majsterklepka/varbose-potato/README.md

# varbose-potato
Digital Voltmeter based on ICL7107

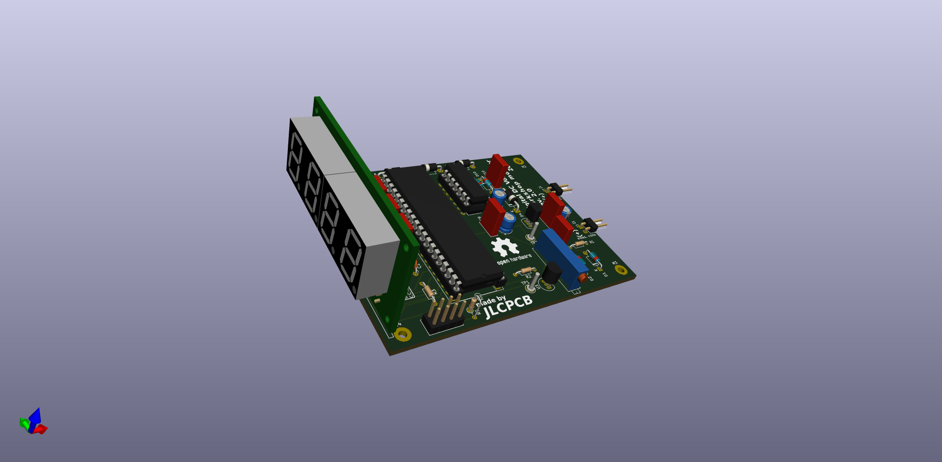
[picture p1: voltmeter/ICL7107.png]
Digital Voltmeter
