majsterklepka/varbose-potato/voltmeter/BOM.ods

Digital DC Voltmeter BOM
Item | Qty | Reference(s) | Value | URL | Comments
1 | 1 | C1 | 100p | https://sklep.avt.pl/45298.html
2 | 2 | C2, C3 | 0.47u | https://sklep.avt.pl/45319.html
3 |  | C4 | 0.22u | https://sklep.avt.pl/41558.html
4 | 1 | C5 | 0.1u | https://sklep.avt.pl/41542.html
5 | 2 | C6, C8 | 100u | https://sklep.avt.pl/kondensator-elektrolityczny-100uf-16v.html
6 | 2 | C7, C9 | 100n | https://sklep.avt.pl/41542.html
7 | 1 | C10 | 0.47u | https://sklep.avt.pl/45319.html
8 | 1 | C11 | 10u | https://sklep.avt.pl/kondensator-elektrolityczny-10uf-50v-10-szt.html
9 | 2 | D1, D2 | 1N4148 | https://sklep.avt.pl/42281.html
10 | 1 | D3 | LED-Display_x4_CA |  | module with two double display 0.56’’ CA
11 | 5 | D4, D5, D6, D7, D8 | 1N4001 | https://sklep.avt.pl/42280.html
12 | 2 | D9, D10 | 1N914 | https://allegro.pl/oferta/dioda-1n914-300ma-100v-do35-tht-x20szt-7876530202 | 1N4148
13 | 1 | G1 | CC-BY-SA
14 | 1 | J1 | +9...12V DC | https://sklep.avt.pl/zlacze-srubowe-dg301-5-0-2-raster-5mm-wys-10mm-niebieski-ark2-500.html
15 | 1 | J2 | DP conn. | https://sklep.avt.pl/listwa-kolkowa-2x40-prosta-gold-pin.html
16 | 1 | J3 | meas. conn | https://sklep.avt.pl/zlacze-srubowe-dg301-5-0-2-raster-5mm-wys-10mm-niebieski-ark2-500.html
17 | 1 | LOGO1 | Logo_Open_Hardware_Large
18 | 4 | M1, M2, M3, M4 | M2.2
19 | 1 | R1 | 1M | https://sklep.avt.pl/rezystor-1mom-1-4w-5-0207-10-szt.html
20 | 1 | R2 | 6k8 | https://sklep.avt.pl/rezystor-6-8kom-1-4w-5-0207-10-szt.html
21 | 1 | R3 | 100k | https://sklep.avt.pl/rezystor-100kom-1-4w-5-0207-10-szt.html
22 | 1 | R4 | 47k | https://sklep.avt.pl/rezystor-47kom-1-4w-5-0207-10-szt.html
23 | 1 | R5 | 470R | https://sklep.avt.pl/rezystor-470om-1-4w-5-0207-10-szt.html
24 | 1 | RV1 | 20k | https://sklep.avt.pl/potencjometr-pr20kom-helitrim-3006p.html
25 | 1 | U1 | LM285Z-1.2 | https://allegro.pl/oferta/lm285z-zrodlo-napiecia-odniesienia-1-2v-icl8069-7283614293
26 | 1 | U2 | ICL7107 | https://sklep.avt.pl/uklad-scalony-icl7107.html | socket: https://sklep.avt.pl/podstawka-40-pin.html
27 | 1 | U3 | L7805
28 | 1 | U4 | CD4069 | https://sklep.avt.pl/uklad-scalony-4069.html | socket: https://sklep.avt.pl/podstawka-14-pin.html
29 | 2 | TP1,TP2 | goldpin | https://sklep.avt.pl/kolek-lutowniczy-10szt.html
