majsterklepka/varbose-potato/display-module/BOM.ods

Display-module
Reference | Quantity | Value | URL | Comments
D1 D2 | 2 | HDSP-5623-CA | https://sklep.avt.pl/wyswietlacz-czerwony-2-cyfry-14-2mm-wa.html | various CA LED Display 0.56’’
J1 J2 | 2 | Conn_DP1 | https://sklep.avt.pl/listwa-kolkowa-2x40-katowa-gold-pin.html
M1 M2 M4 M3 | 4 | Conn_01x01
