majsterklepka/varbose-potato/ICL7107.pdf

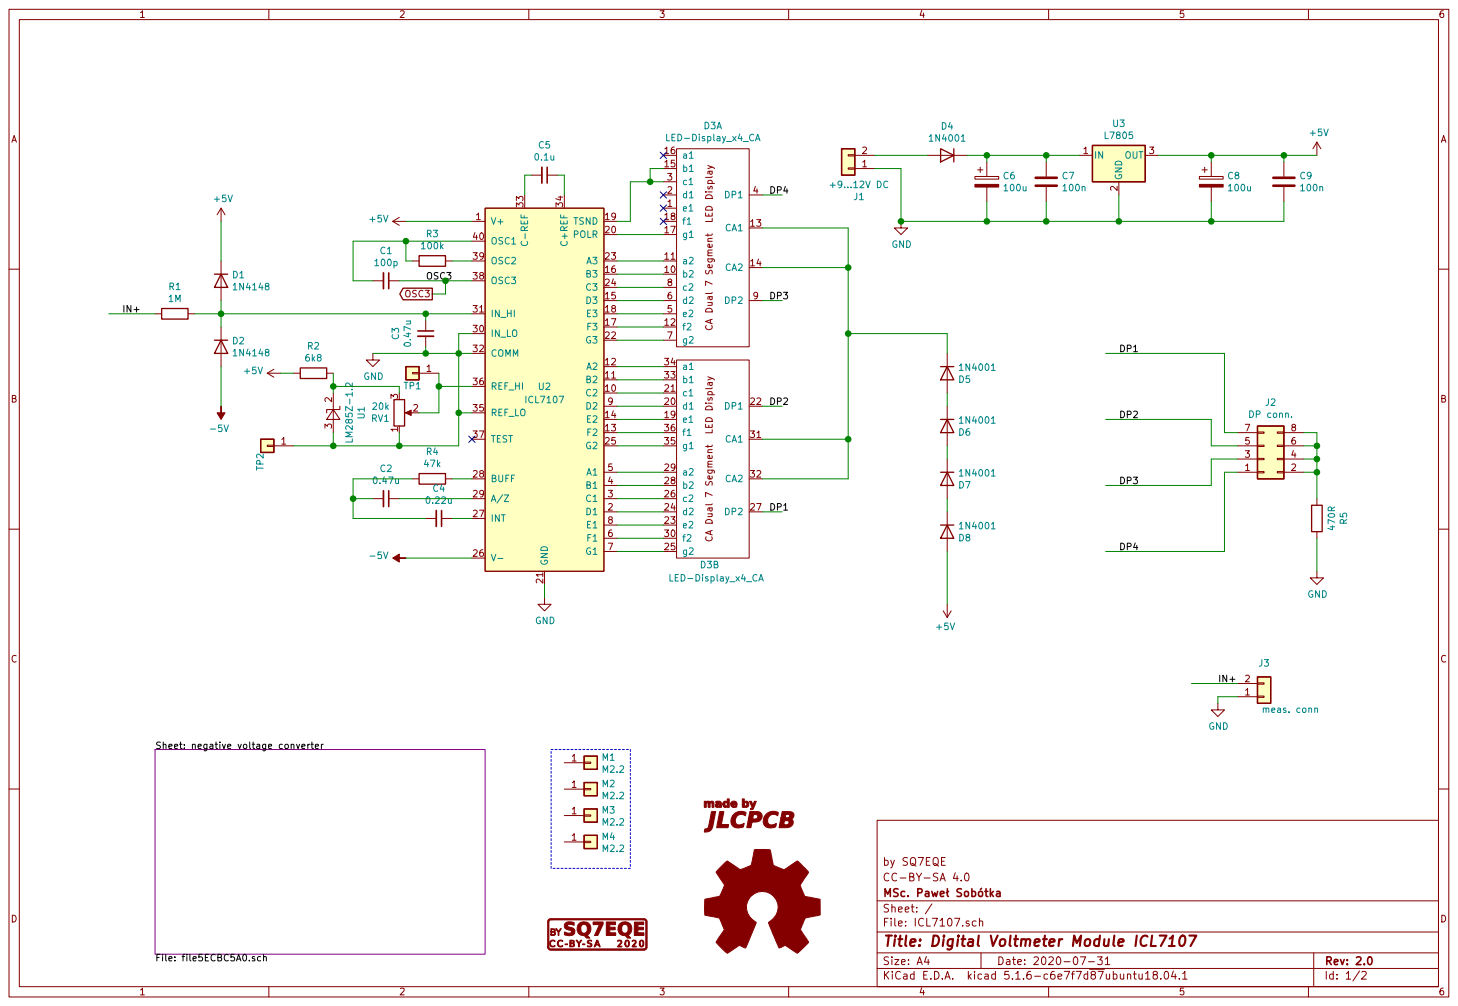
[picture p2: page 1]

LED-Display_x4_CA CA Dual 7 Segment LED Display e1 1

Sheet: negative voltage converter File: file5ECBC5A0.sch

by SQ7EQE
File: ICL7107.sch Sheet: / MSc. Pawe Sobótka CC-BY-SA 4.0

Id: 1/2 Title: Digital Voltmeter Module ICL7107

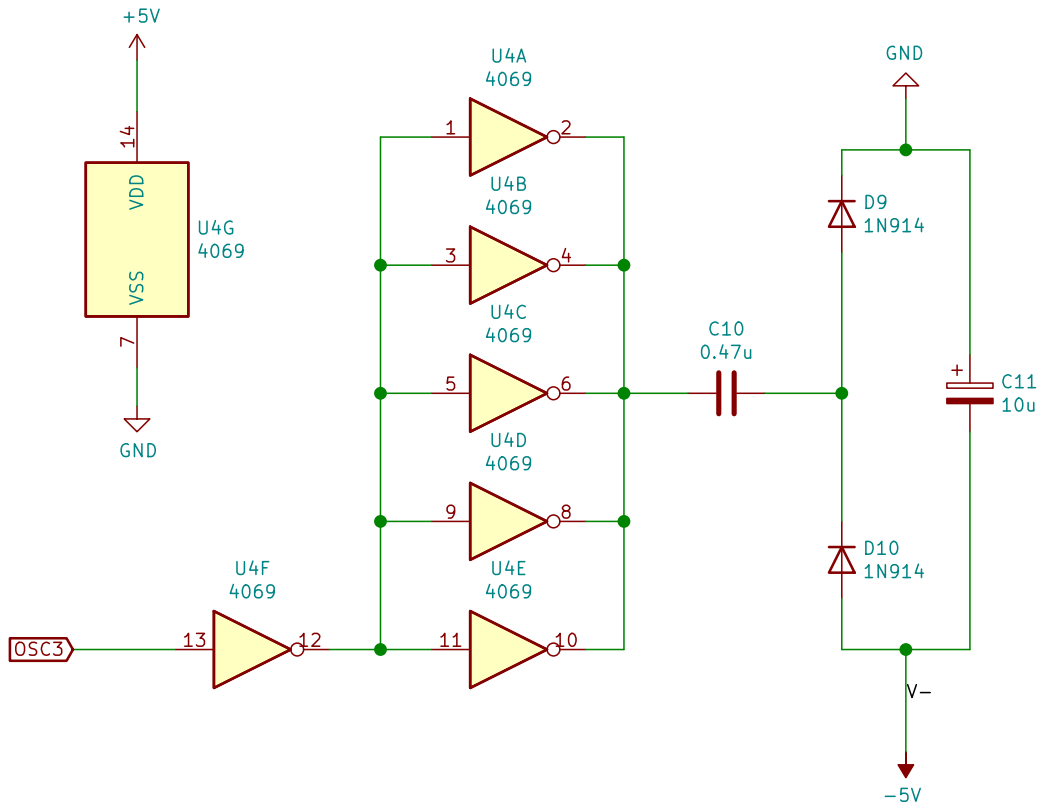
[picture p3: page 2]

by SQ7EQE
MSc. Pawe Sobótka CC-BY-SA 4.0

Id: 2/2 Title: negative voltage converter File: file5ECBC5A0.sch Sheet: /negative voltage converter/
