majsterklepka/varbose-potato/voltmeterac.pdf

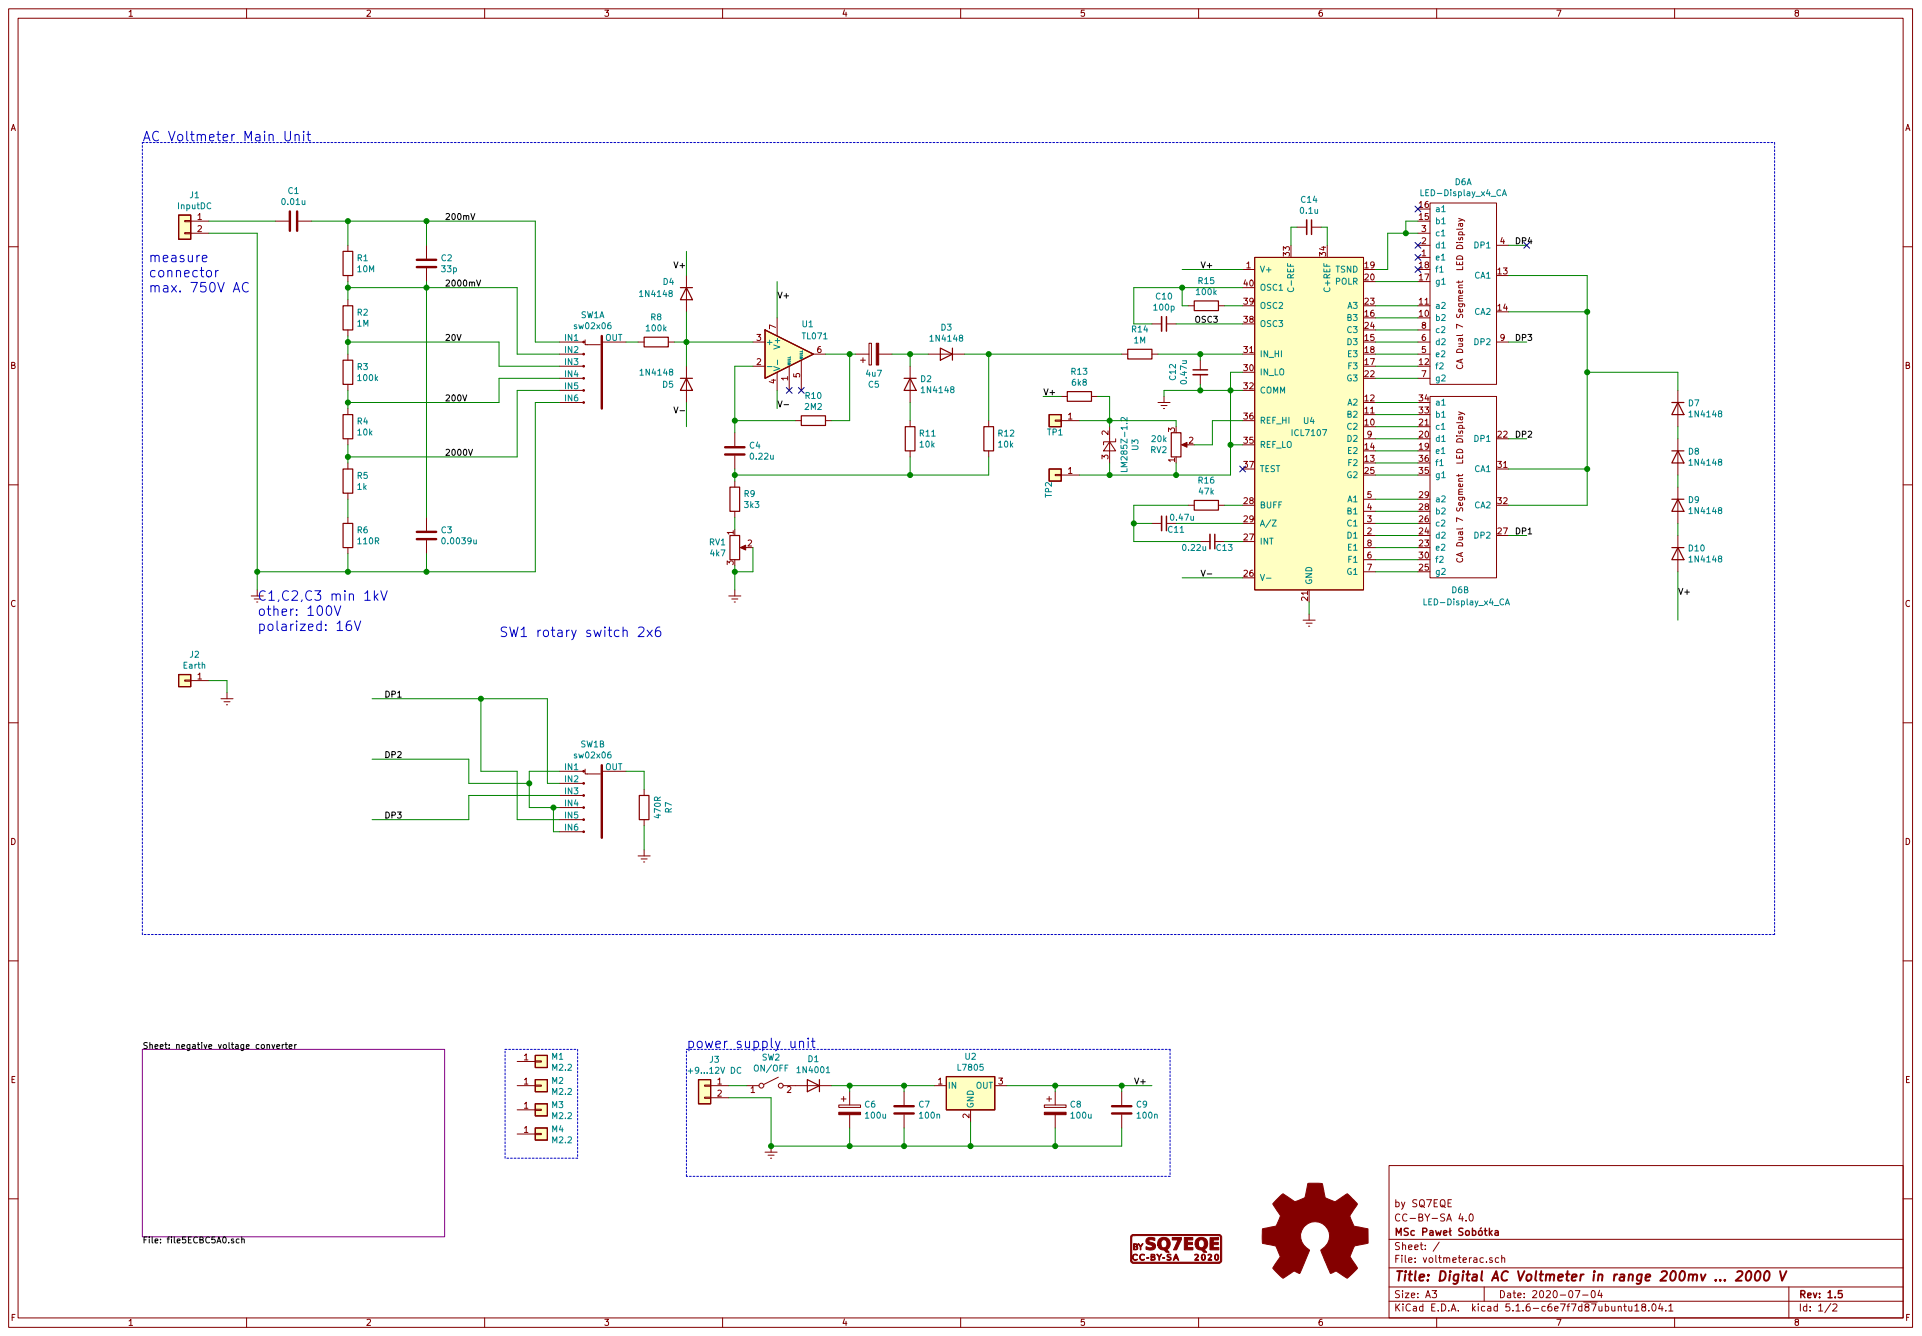
[picture p4: page 1]

AC Voltmeter Main Unit

Sheet: negative voltage converter File: file5ECBC5A0.sch

by SQ7EQE
File: voltmeterac.sch Sheet: / MSc Pawe Sobótka CC-BY-SA 4.0

Id: 1/2 Title: Digital AC Voltmeter in range 200mv ... 2000 V

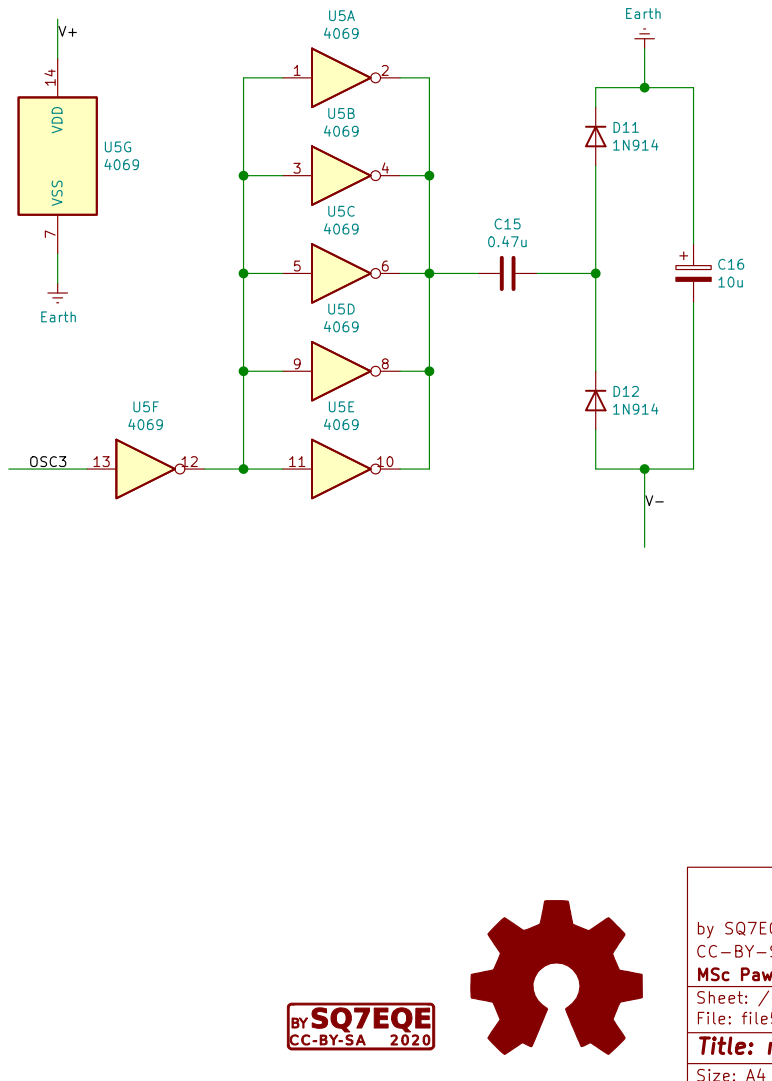
[picture p5: page 2]

by SQ7EQE
MSc Pawe Sobótka CC-BY-SA 4.0

Id: 2/2 Title: negative voltage converter File: file5ECBC5A0.sch Sheet: /negative voltage converter/
