majsterklepka/varbose-potato/voltmeterdc.pdf

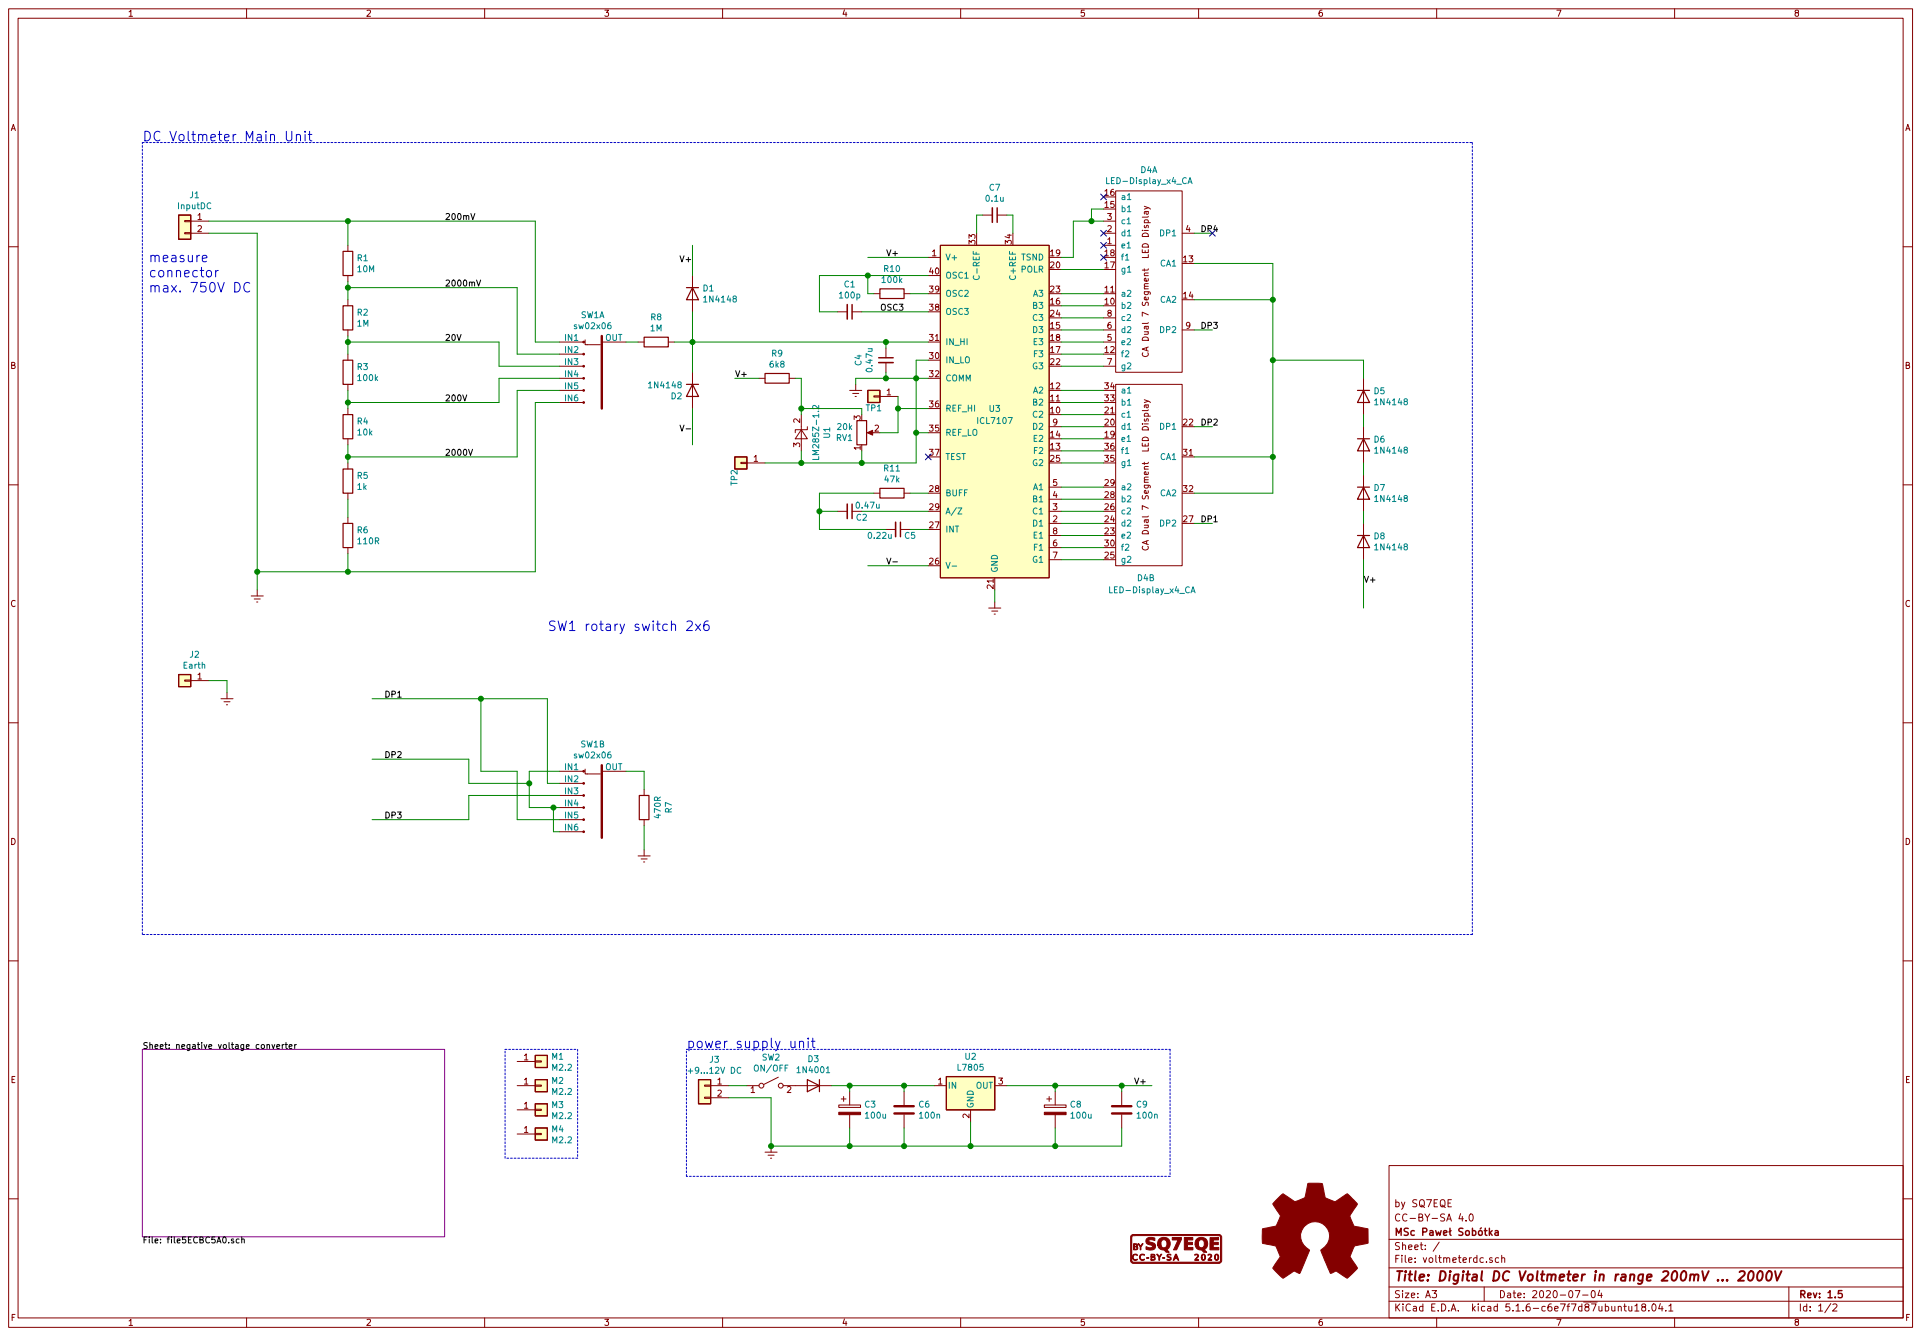
[picture p6: page 1]

Sheet: negative voltage converter File: file5ECBC5A0.sch

by SQ7EQE
File: voltmeterdc.sch Sheet: / MSc Pawe Sobótka CC-BY-SA 4.0

Id: 1/2 Title: Digital DC Voltmeter in range 200mV ... 2000V

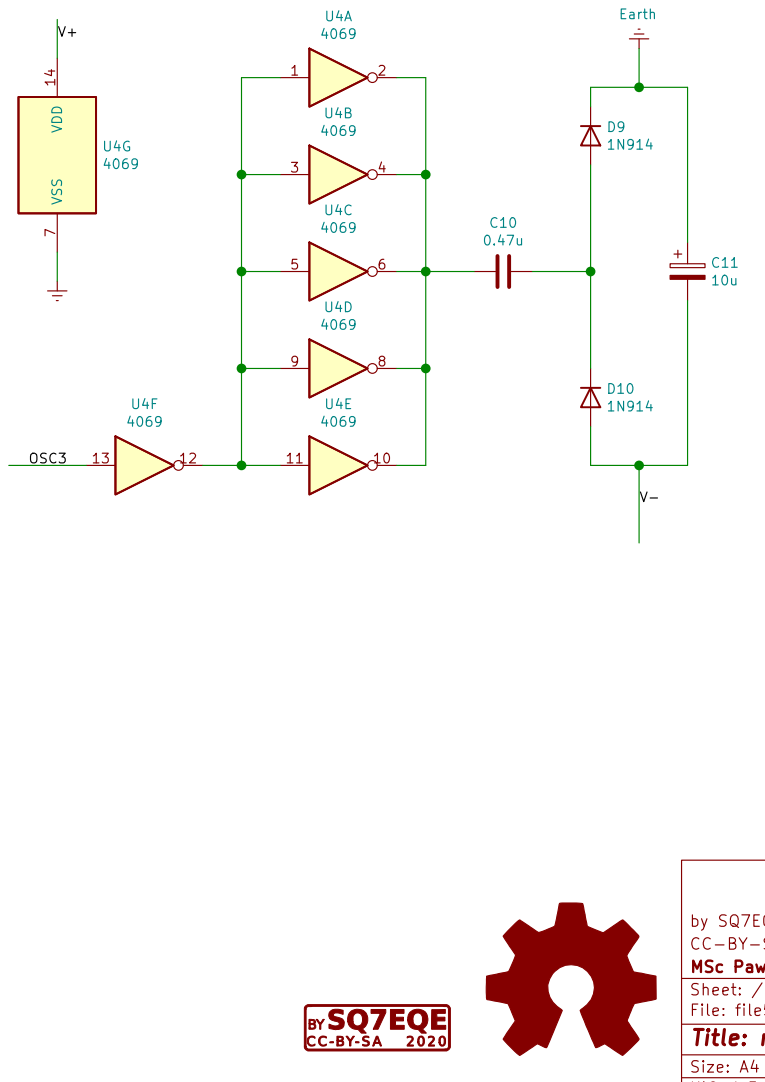
[picture p7: page 2]

by SQ7EQE
MSc Pawe Sobótka CC-BY-SA 4.0

Id: 2/2 Title: negative voltage converter File: file5ECBC5A0.sch Sheet: /negative voltage converter/
