majsterklepka/varbose-potato/(list of files, drawings)

Other design files:
display-module/LED-display_x4.dsn
voltmeter/ICL7107.dsn
