majsterklepka/varbose-potato/voltmeter/ICL7107.kicad_pcb

## KiCad design voltmeter/ICL7107.kicad_pcb (2020-08-07)

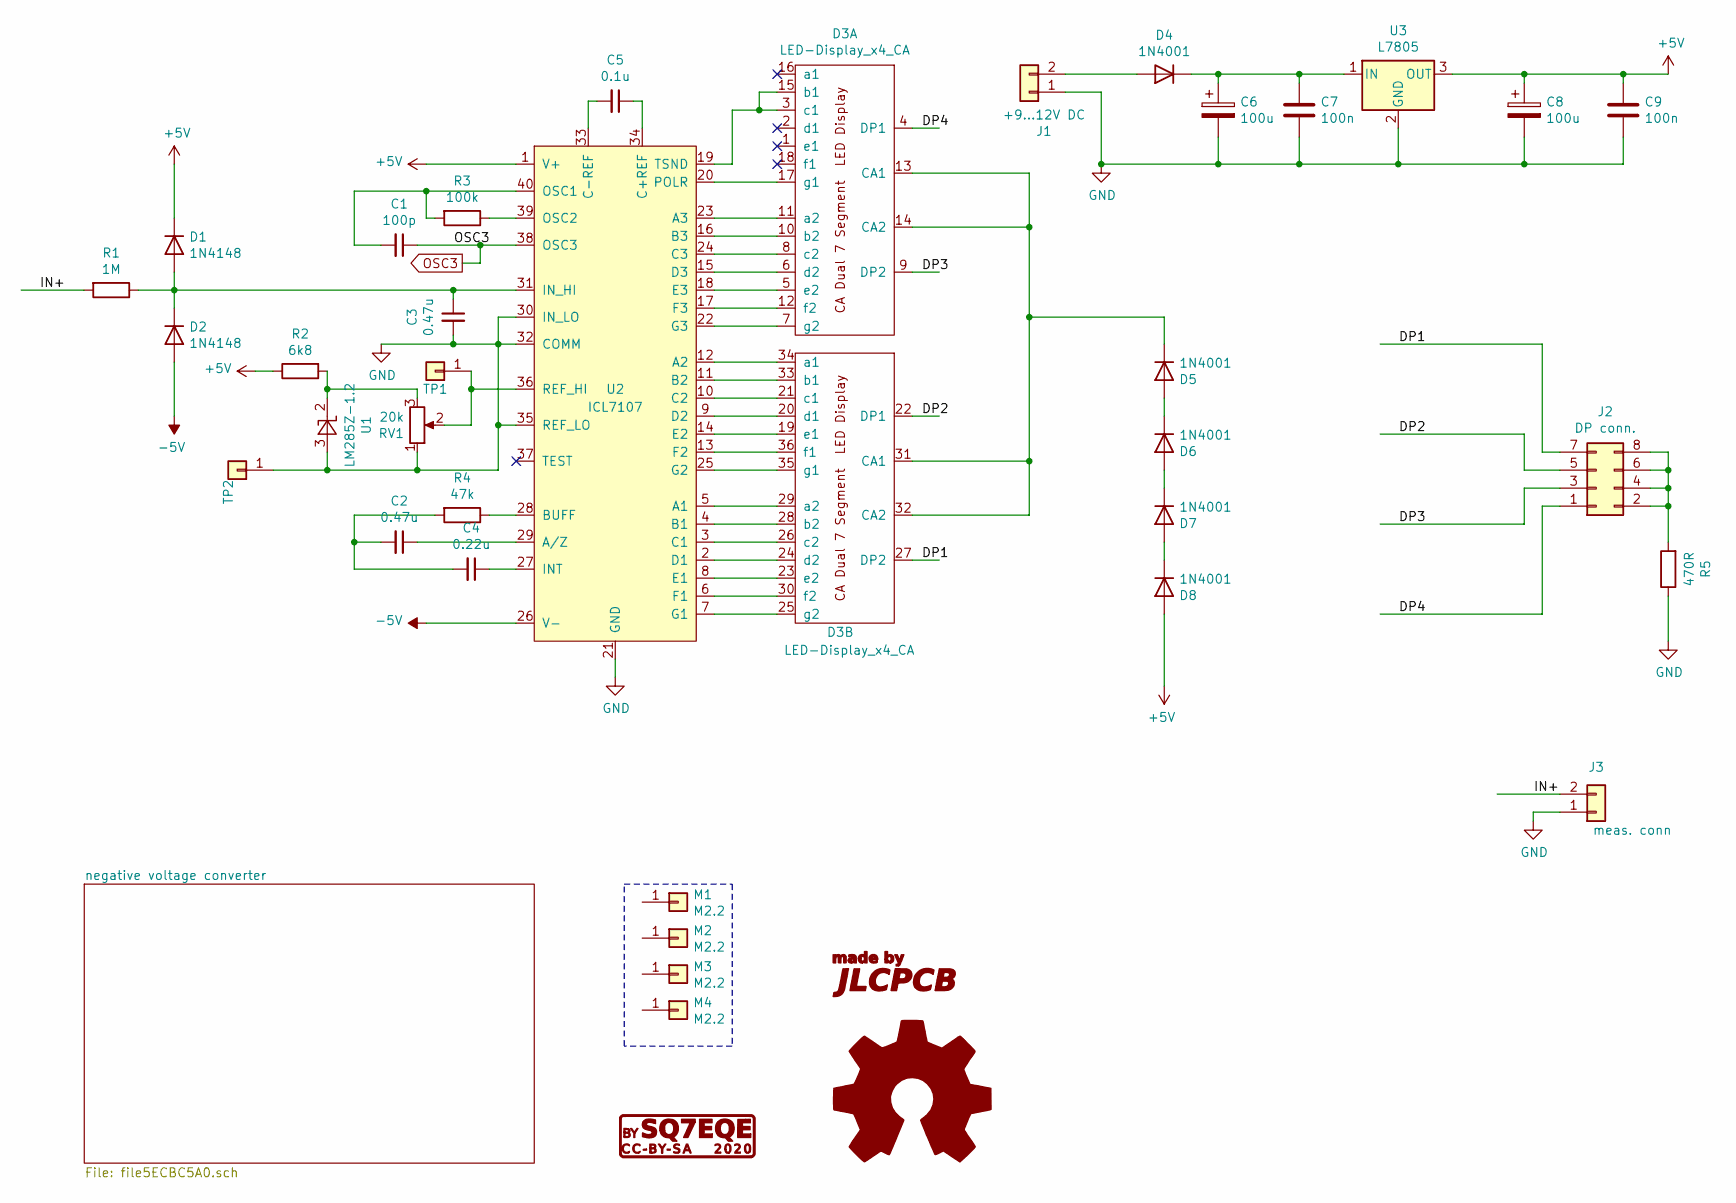
[picture p8: schematic ICL7107.sch, Digital Voltmeter Module ICL7107]

Parts:
C1: 100p; C_Disc_D4.3mm_W1.9mm_P5.00mm
C2, C3: 0.47u; C_Rect_L7.0mm_W2.5mm_P5.00mm
C4: 0.22u; C_Rect_L7.0mm_W2.5mm_P5.00mm
C5: 0.1u; C_Rect_L7.0mm_W2.5mm_P5.00mm
C6, C8: 100u; CP_Radial_D5.0mm_P2.50mm
C7, C9: 100n; C_Rect_L7.0mm_W2.5mm_P5.00mm
D1, D2: 1N4148; D_DO-35_SOD27_P7.62mm_Horizontal
D3: LED-Display_x4_CA; LED-Display_x4_package
D4, D5, D6, D7, D8: 1N4001; D_DO-41_SOD81_P10.16mm_Horizontal
G1: CC-BY-SA; cc-by-sa
G2: JLCPCB; jlcpcb
J1: +9...12V DC; PinHeader_1x02_P2.54mm_Horizontal
J2: DP conn.; PinHeader_2x04_P2.54mm_Vertical
J3: meas. conn; PinHeader_1x02_P2.54mm_Horizontal
LOGO1: Logo_Open_Hardware_Large; OSHW-Logo2_14.6x12mm_SilkScreen
M1, M2, M3, M4: M2.2; MountingHole_2.2mm_M2_Pad
R1: 1M; R_Axial_DIN0204_L3.6mm_D1.6mm_P7.62mm_Horizontal
R2: 6k8; R_Axial_DIN0204_L3.6mm_D1.6mm_P7.62mm_Horizontal
R3: 100k; R_Axial_DIN0204_L3.6mm_D1.6mm_P7.62mm_Horizontal
R4: 47k; R_Axial_DIN0204_L3.6mm_D1.6mm_P7.62mm_Horizontal
R5: 470R; R_Axial_DIN0204_L3.6mm_D1.6mm_P2.54mm_Vertical
RV1: 20k; Potentiometer_Vishay_43_Horizontal
TP1, TP2: Pin_D1.3mm_L11.0mm
U1: LM285Z-1.2; TO-92_Inline
U2: ICL7107; DIP-40_W15.24mm_Socket
U3: L7805; TO-220-3_Vertical

Connections:
+5V: C8.1, C9.1, D1.1 (K), D8.2 (A), R2.1, U2.1 (V+), U3.3 (OUT); also elsewhere on the board
-5V: D2.2 (A), U2.26 (V-); also elsewhere on the board
/DP1: D3.27 (DP2), J2.7
/DP2: D3.22 (DP1), J2.5
/DP3: D3.9 (DP2), J2.3
/DP4: D3.4 (DP1), J2.1
/IN+: J3.2, R1.2
GND: C3.2, C6.2, C7.2, C8.2, C9.2, J1.1, J3.1, R5.1, RV1.1, TP2.1, U1.3 (A), U2.21 (GND), U2.30 (IN_LO), U2.32 (COMM), U2.35 (REF_LO), U3.2 (GND); also elsewhere on the board
unnamed: C1.2, R3.2, U2.40 (OSC1)
unnamed: C2.1, U2.29 (A/Z)
unnamed: C2.2, C4.2, R4.2
unnamed: C3.1, D1.2 (A), D2.1 (K), R1.1, U2.31 (IN_HI)
unnamed: C4.1, U2.27 (INT)
unnamed: C5.1, U2.34 (C+REF)
unnamed: C5.2, U2.33 (C-REF)
unnamed: C6.1, C7.1, D4.1 (K), U3.1 (IN)
unnamed: D3.5 (e2), U2.18 (E3)
unnamed: D3.6 (d2), U2.15 (D3)
unnamed: D3.7 (g2), U2.22 (G3)
unnamed: D3.8 (c2), U2.24 (C3)
unnamed: D3.10 (b2), U2.16 (B3)
unnamed: D3.11 (a2), U2.23 (A3)
unnamed: D3.12 (f2), U2.17 (F3)
unnamed: D3.13 (CA1), D3.14 (CA2), D3.31 (CA1), D3.32 (CA2), D5.1 (K)
unnamed: D3.3 (c1), D3.15 (b1), U2.19 (TSND)
unnamed: D3.17 (g1), U2.20 (POLR)
unnamed: D3.19 (e1), U2.14 (E2)
unnamed: D3.20 (d1), U2.9 (D2)
unnamed: D3.21 (c1), U2.10 (C2)
unnamed: D3.23 (e2), U2.8 (E1)
unnamed: D3.24 (d2), U2.2 (D1)
unnamed: D3.25 (g2), U2.7 (G1)
unnamed: D3.26 (c2), U2.3 (C1)
unnamed: D3.28 (b2), U2.4 (B1)
unnamed: D3.29 (a2), U2.5 (A1)
unnamed: D3.30 (f2), U2.6 (F1)
unnamed: D3.33 (b1), U2.11 (B2)
unnamed: D3.34 (a1), U2.12 (A2)
unnamed: D3.35 (g1), U2.25 (G2)
unnamed: D3.36 (f1), U2.13 (F2)
unnamed: D4.2 (A), J1.2
unnamed: D5.2 (A), D6.1 (K)
unnamed: D6.2 (A), D7.1 (K)
unnamed: D7.2 (A), D8.1 (K)
unnamed: J2.2, J2.4, J2.6, J2.8, R5.2
unnamed: R2.2, RV1.3, U1.2 (K)
unnamed: R3.1, U2.39 (OSC2)
unnamed: R4.1, U2.28 (BUFF)
unnamed: RV1.2, TP1.1, U2.36 (REF_HI)
OSC3: C1.1, U2.38 (OSC3); also elsewhere on the board

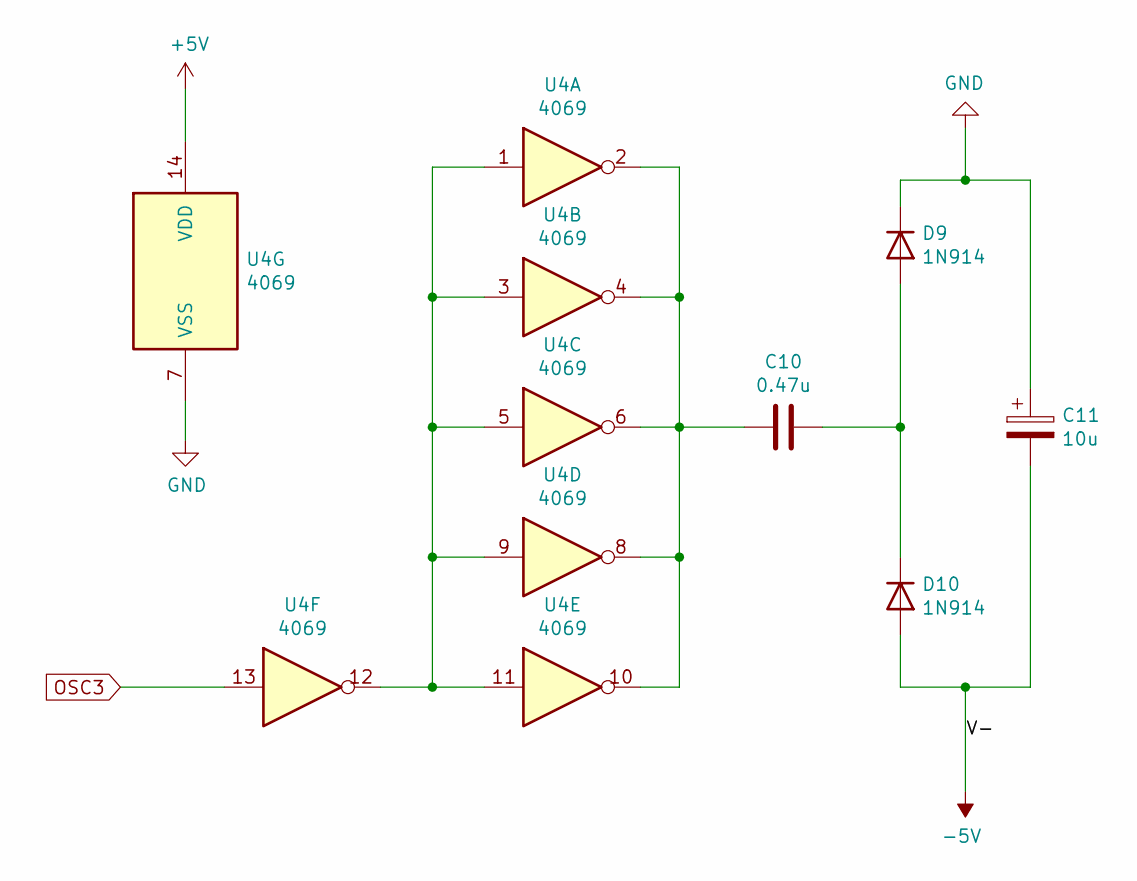
[picture p9: schematic file5ECBC5A0.sch, negative voltage converter]

Parts:
C10: 0.47u; C_Rect_L7.0mm_W2.5mm_P5.00mm
C11: 10u; CP_Radial_D5.0mm_P2.50mm
D9, D10: 1N914; D_DO-35_SOD27_P7.62mm_Horizontal
U4: 4069; DIP-14_W7.62mm

Connections:
+5V: U4.14 (VDD); also elsewhere on the board
-5V: C11.2, D10.2 (A); also elsewhere on the board
GND: C11.1, D9.1 (K), U4.7 (VSS); also elsewhere on the board
unnamed: C10.1, D9.2 (A), D10.1 (K)
unnamed: C10.2, U4.2, U4.4, U4.6, U4.8, U4.10
unnamed: U4.1, U4.3, U4.5, U4.9, U4.11, U4.12
OSC3: U4.13; also elsewhere on the board

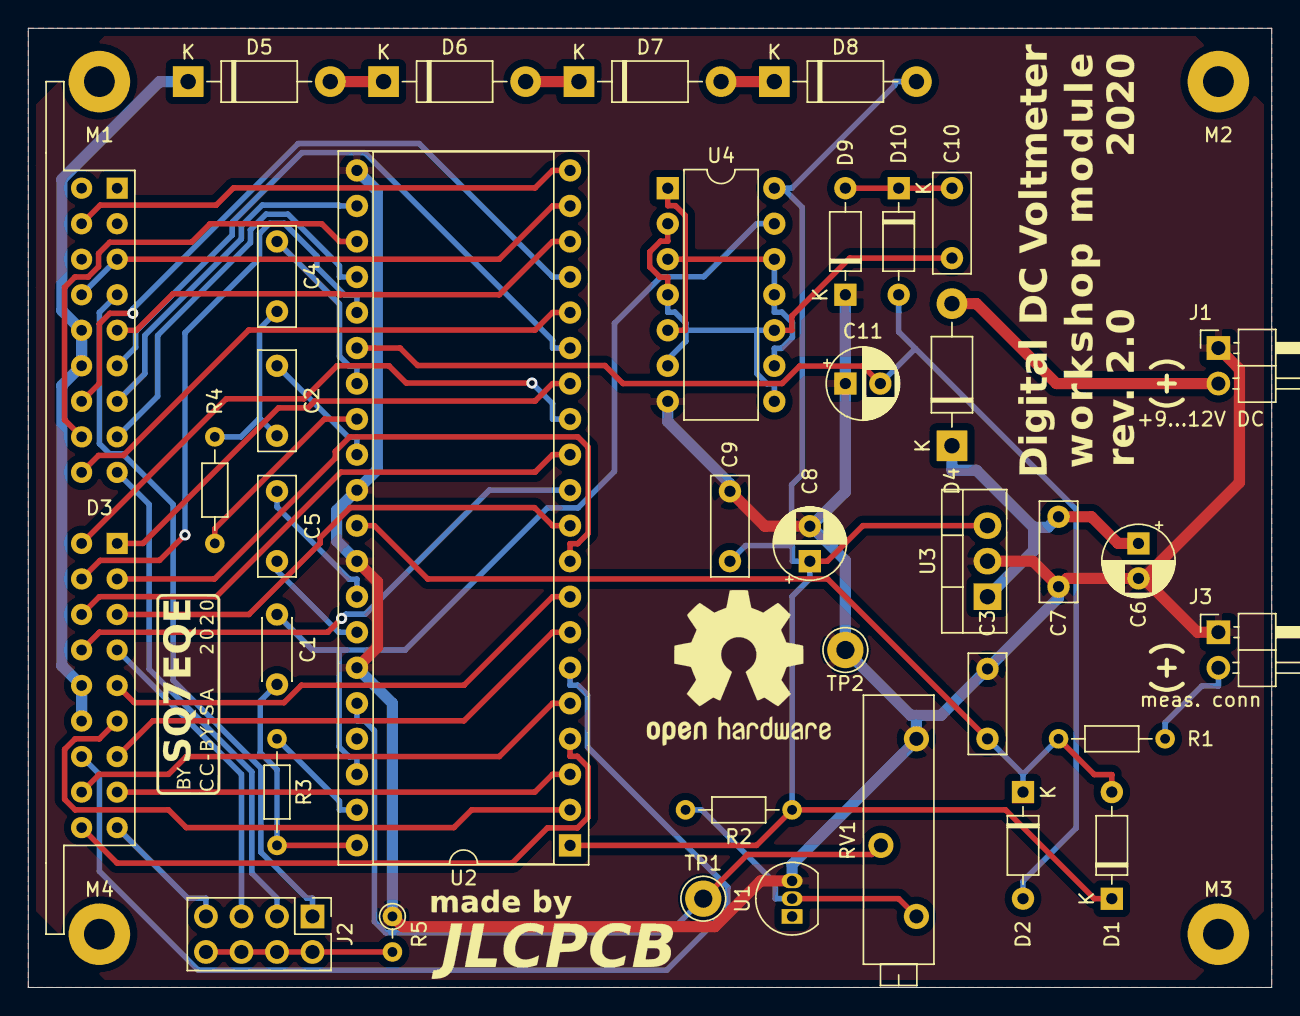
[picture p10: board ICL7107.kicad_pcb from above]

Board: 2 copper layers, 88.9 x 68.6 mm, 43 parts (0 on the bottom side), 53 nets.
