majsterklepka/varbose-potato/display-module/LED-display_x4.kicad_pcb

## KiCad design display-module/LED-display_x4.kicad_pcb (2020-07-29)

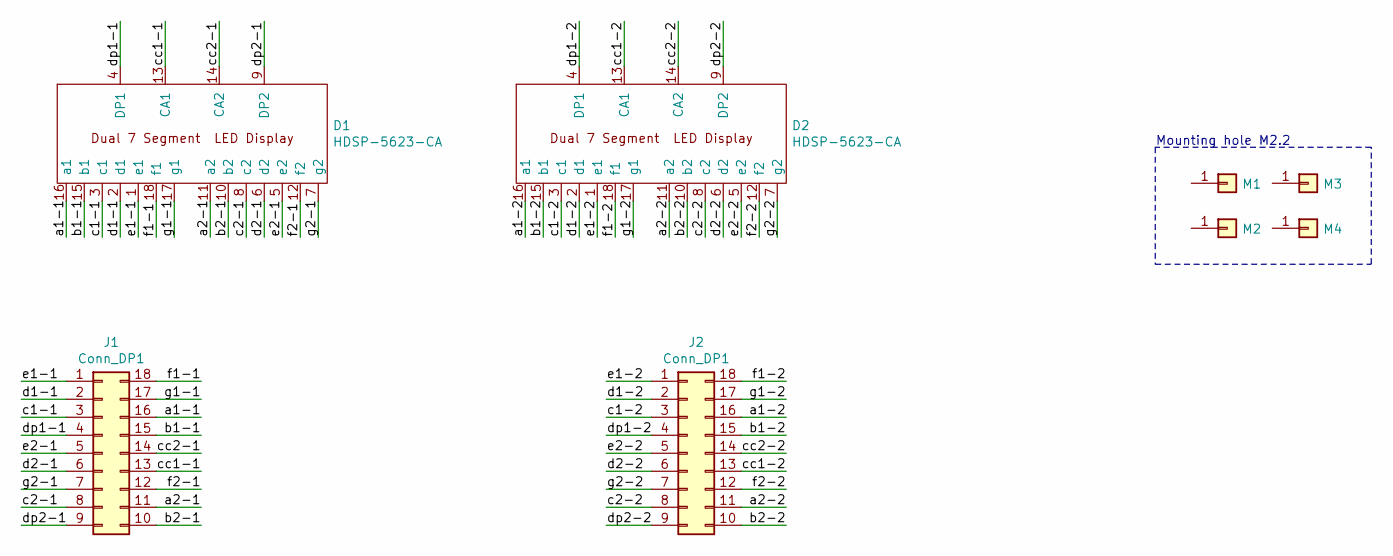
[picture p11: schematic LED-display_x4.sch, Moduł wyświetlacza LED 4 cyfry]

Parts:
D1, D2: HDSP-5623-CA; package_led_display_0.56in_dual
J1, J2: Conn_DP1; PinHeader_2x09_P2.54mm_Horizontal
M1, M2, M3, M4: Conn_01x01; MountingHole_2.2mm_M2

Connections:
/a1-1: D1.16 (a1), J1.16
/a1-2: D2.16 (a1), J2.16
/a2-1: D1.11 (a2), J1.11
/a2-2: D2.11 (a2), J2.11
/b1-1: D1.15 (b1), J1.15
/b1-2: D2.15 (b1), J2.15
/b2-1: D1.10 (b2), J1.10
/b2-2: D2.10 (b2), J2.10
/c1-1: D1.3 (c1), J1.3
/c1-2: D2.3 (c1), J2.3
/c2-1: D1.8 (c2), J1.8
/c2-2: D2.8 (c2), J2.8
/cc1-1: D1.13 (CA1), J1.13
/cc1-2: D2.13 (CA1), J2.13
/cc2-1: D1.14 (CA2), J1.14
/cc2-2: D2.14 (CA2), J2.14
/d1-1: D1.2 (d1), J1.2
/d1-2: D2.2 (d1), J2.2
/d2-1: D1.6 (d2), J1.6
/d2-2: D2.6 (d2), J2.6
/dp1-1: D1.4 (DP1), J1.4
/dp1-2: D2.4 (DP1), J2.4
/dp2-1: D1.9 (DP2), J1.9
/dp2-2: D2.9 (DP2), J2.9
/e1-1: D1.1 (e1), J1.1
/e1-2: D2.1 (e1), J2.1
/e2-1: D1.5 (e2), J1.5
/e2-2: D2.5 (e2), J2.5
/f1-1: D1.18 (f1), J1.18
/f1-2: D2.18 (f1), J2.18
/f2-1: D1.12 (f2), J1.12
/f2-2: D2.12 (f2), J2.12
/g1-1: D1.17 (g1), J1.17
/g1-2: D2.17 (g1), J2.17
/g2-1: D1.7 (g2), J1.7
/g2-2: D2.7 (g2), J2.7

Notes on the sheet:
Mounting hole M2.2

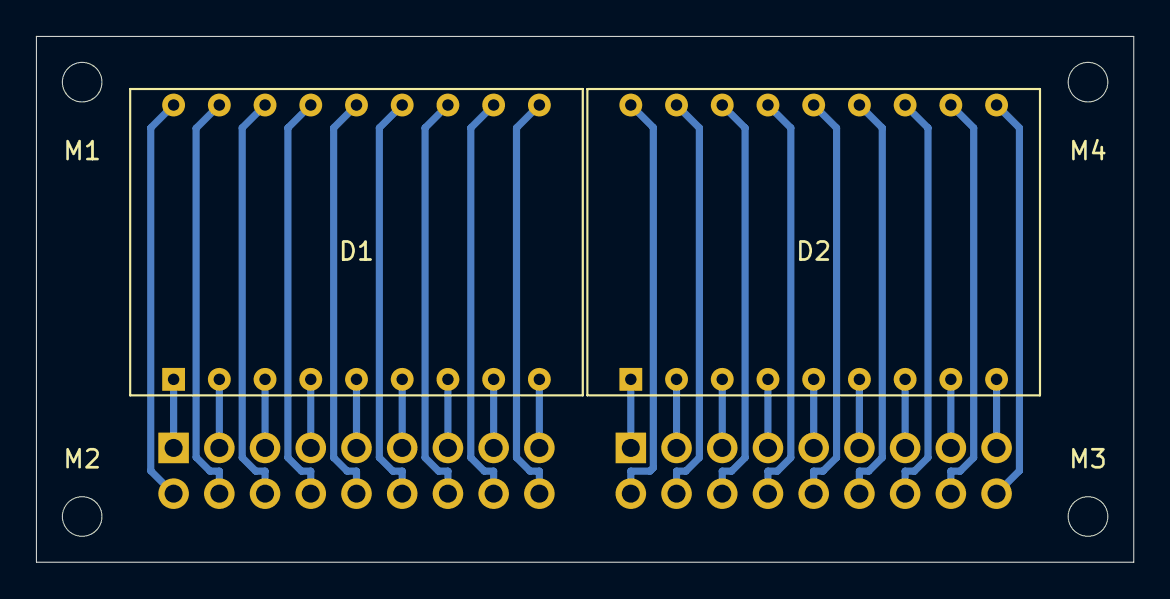
[picture p12: board LED-display_x4.kicad_pcb from above]

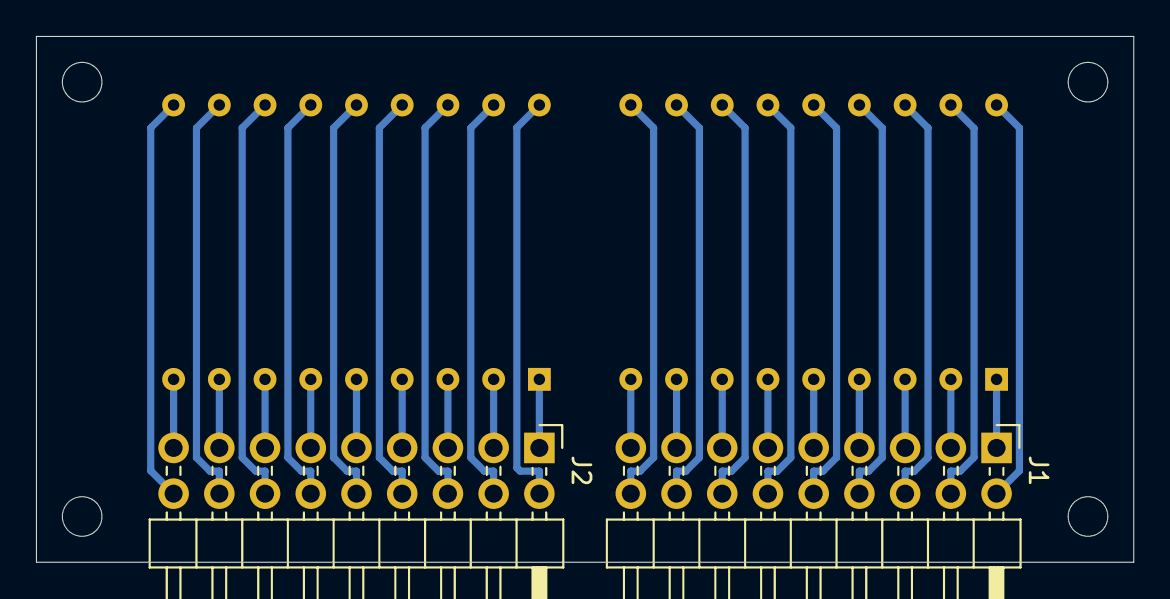
[picture p13: board LED-display_x4.kicad_pcb from below]

Board: 2 copper layers, 61.0 x 29.2 mm, 8 parts (2 on the bottom side), 36 nets.
