majsterklepka/varbose-potato/(commit log)

2020-06-01 update file
    [ICL7107.kicad_pcb]
2020-06-02 updated file
    [DIP-14_W7.62mm_Socket_package.step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]
2020-06-30 update file
    I make mistake in schematics library & footprint library
    now devices are correct, I divided 7 segment display at
    two separate CA & CC
    bye!
    [ICL7107-B_Cu.gbr, ICL7107-B_SilkS.gbr, ICL7107-Edge_Cuts.gbr, ICL7107-F_CrtYd.gbr, ICL7107-F_Cu.gbr, ICL7107-F_Fab.gbr, ICL7107-F_SilkS.gbr, ICL7107-job.gbrjob]
2020-06-30 update
    Zmodyfikowałem schemat i tym samym projekt płytki drukowanej
    usunąłem zbędne rezystory i poprawnie połączyłem dp wyświetlaczy
    [ICL7107.dsn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]
2020-07-05 update file
    poprawiłem schemat i ponownie wygenerowałem pliki Gerber
    I corrected the diagram and re-generated the Gerber files
    [ICL7107-B_Cu.gbr, ICL7107-B_SilkS.gbr, ICL7107-Edge_Cuts.gbr, ICL7107-F_CrtYd.gbr, ICL7107-F_Cu.gbr, ICL7107-F_SilkS.gbr, ICL7107-job.gbrjob, ICL7107.drl]
2020-07-07 generate BOM list
2020-07-08 BOM list update
    [BOM.ods, LED-display_x4.csv]
2020-07-29 update
    Dziś odebrałem płytki z wytwórni płytek, poprawiłem
    projekt footprintów dla wyświetlaczy LED
    pierwotny projekt był na wcisk, teraz po dodaniu 0.1mm na średnicy
    powinno byc lepiej
    [LED-display_x4-B_Cu.gbr, LED-display_x4-B_Mask.gbr, LED-display_x4-Edge_Cuts.gbr, LED-display_x4-F_CrtYd.gbr, LED-display_x4-F_Cu.gbr, LED-display_x4-F_Mask.gbr, LED-display_x4-F_SilkS.gbr, LED-display_x4-job.gbrjob]
2020-07-29 update
    Zmodyfikowałem projekt footprintu dla wyświetlacza LED
    dostosowałem średnicę otworów do średnicy dostępnych wierteł
    ponownie wygenerowałem pliki Gerber
    [LED-display_x4-B_Cu.gbr, LED-display_x4-B_Mask.gbr, LED-display_x4-Edge_Cuts.gbr, LED-display_x4-F_CrtYd.gbr, LED-display_x4-F_Cu.gbr, LED-display_x4-F_Mask.gbr, LED-display_x4-F_SilkS.gbr, LED-display_x4-job.gbrjob]
2020-07-29 new uploaded file with schematic diagram
2020-07-31 update
    I have regenerated Gerber files
    I make correction of schematic diagram
    [ICL7107-B_Cu.gbr, ICL7107-B_Mask.gbr, ICL7107-B_SilkS.gbr, ICL7107-Edge_Cuts.gbr, ICL7107-F_CrtYd.gbr, ICL7107-F_Cu.gbr, ICL7107-F_Mask.gbr, ICL7107-F_SilkS.gbr]
2020-07-31 new file
    uploaded new file:
    - with Gerber files
    - with Kicad footprint module
2020-07-31 new file uploaded
    example application of module
    - AC voltmeter
    - DC voltmeter
    all two schematic diagram in PDF file format
2020-08-07 update file
    uaktualniłem footprint(wyświetlacz LED) i ponownie przygotowałem plik zip
2020-08-07 update file
    ponowne wygenerowanie plików Gerber, powód: uaktualniony footprint
    [LED-display_x4-B_Cu.gbr, LED-display_x4-B_Mask.gbr, LED-display_x4-Edge_Cuts.gbr, LED-display_x4-F_CrtYd.gbr, LED-display_x4-F_Cu.gbr, LED-display_x4-F_Mask.gbr, LED-display_x4-F_SilkS.gbr, LED-display_x4-job.gbrjob]
2020-08-07 upload modified file
    [BOM.ods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]
